tillecki/Miniaturized-PCB-for-MouthIO/Doc/Pictures/Heatplate soldering.jpg

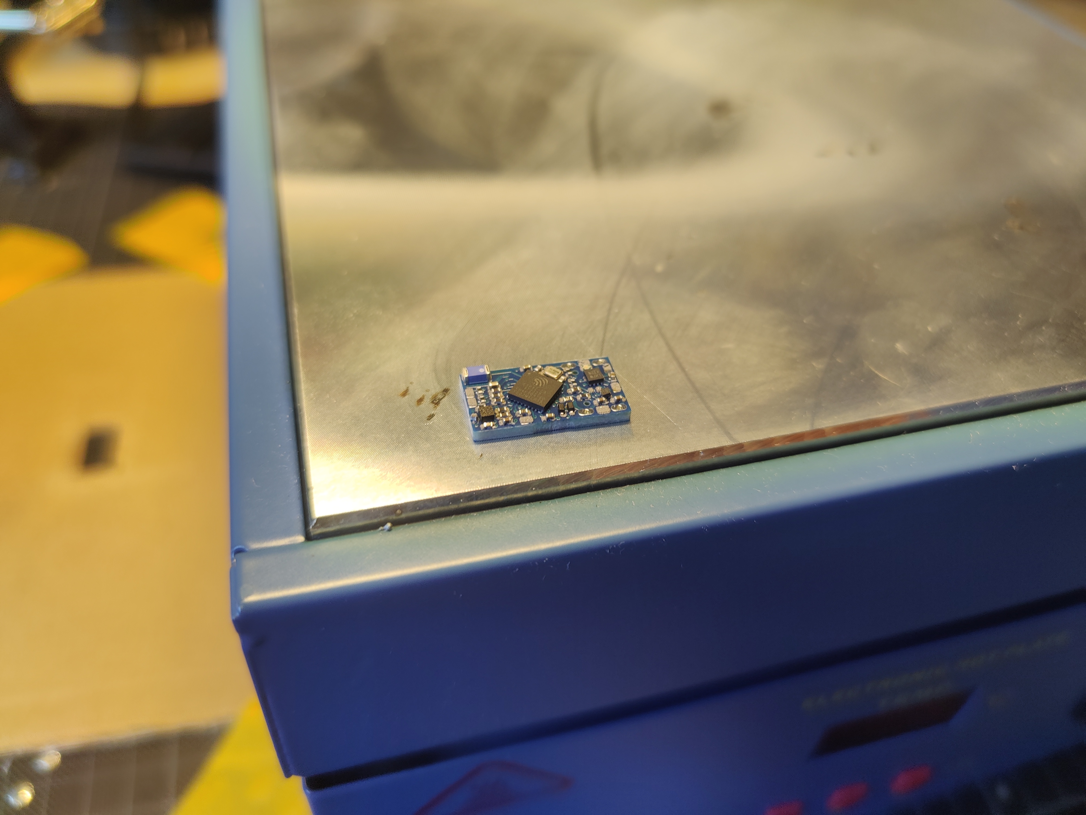
Doc/Pictures/Heatplate soldering.jpg
