tillecki/Miniaturized-PCB-for-MouthIO/Doc/Pictures/CapacitiveTest.png

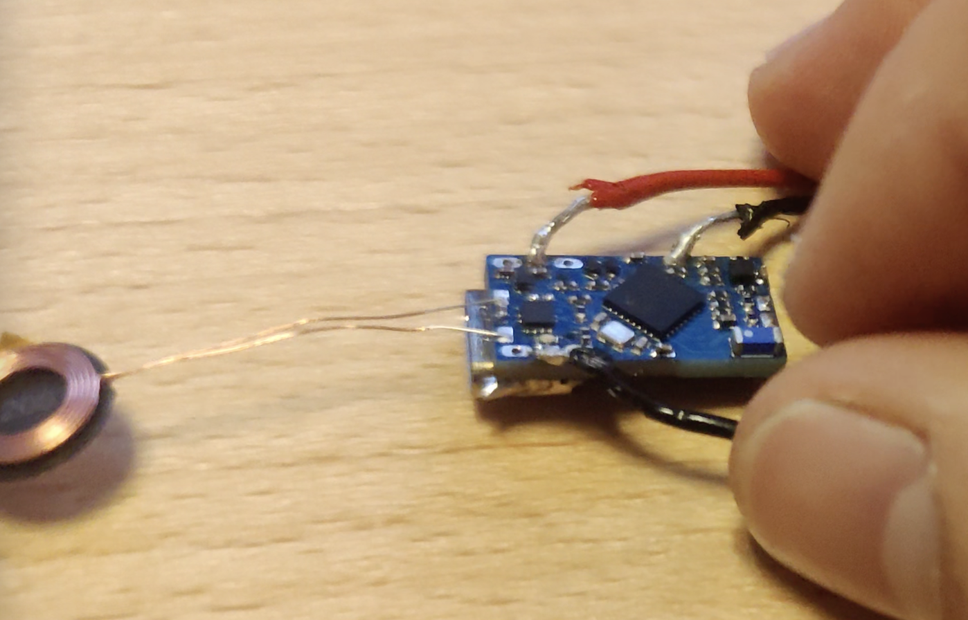
Doc/Pictures/CapacitiveTest.png
