tillecki/Miniaturized-PCB-for-MouthIO/Doc/Pictures/Accelerometertest.png

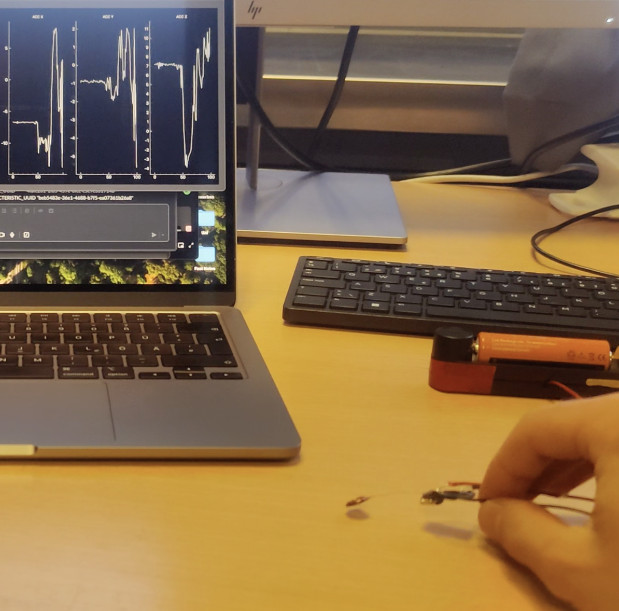
Doc/Pictures/Accelerometertest.png
