tillecki/Miniaturized-PCB-for-MouthIO/Doc/Pictures/Charging on charging station.jpg

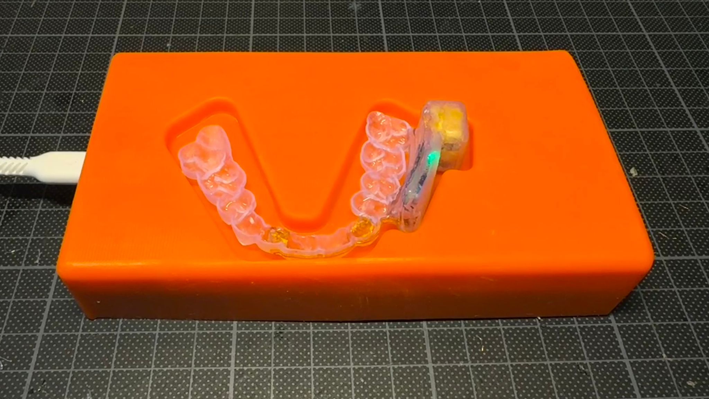
Doc/Pictures/Charging on charging station.jpg
