tillecki/Miniaturized-PCB-for-MouthIO/Doc/Pictures/MouthIO_v3.png

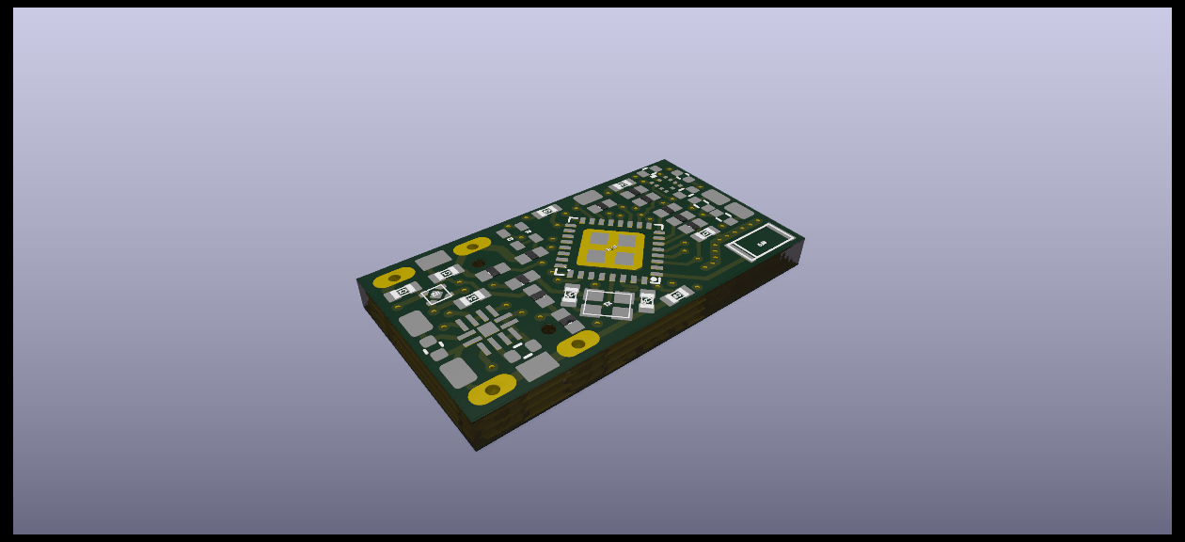
Doc/Pictures/MouthIO_v3.png
