tillecki/Miniaturized-PCB-for-MouthIO/Doc/Pictures/PCB Integrated.jpg

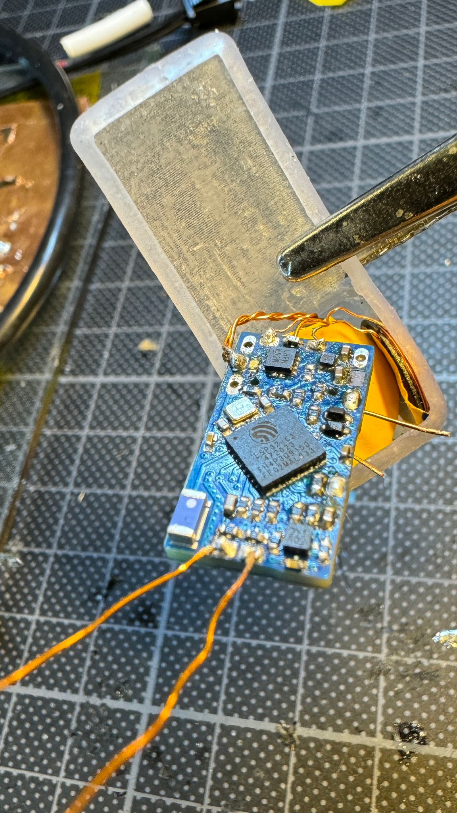
Doc/Pictures/PCB Integrated.jpg
