tillecki/Miniaturized-PCB-for-MouthIO/Doc/Pictures/Program.png

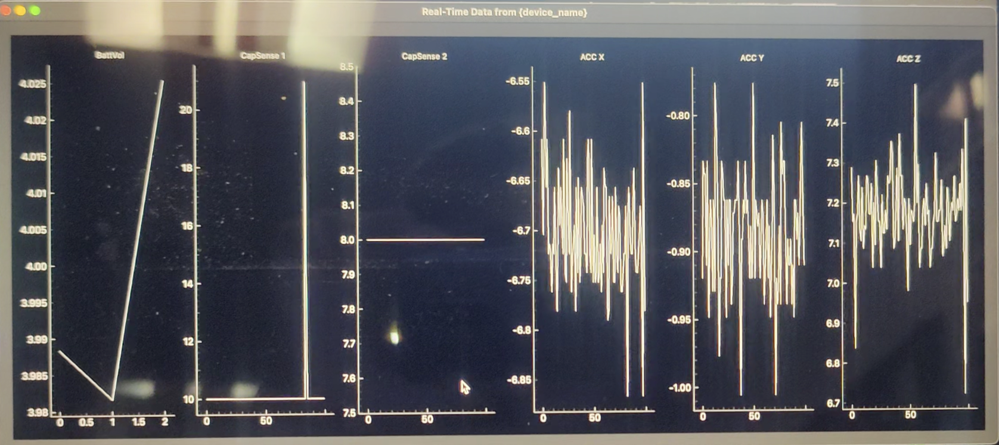
Doc/Pictures/Program.png
