tillecki/Miniaturized-PCB-for-MouthIO/PCB/MouthIO_v3/MouthIO_v3.kicad_pcb

## KiCad design PCB/MouthIO_v3/MouthIO_v3.kicad_pcb (2025-01-16)

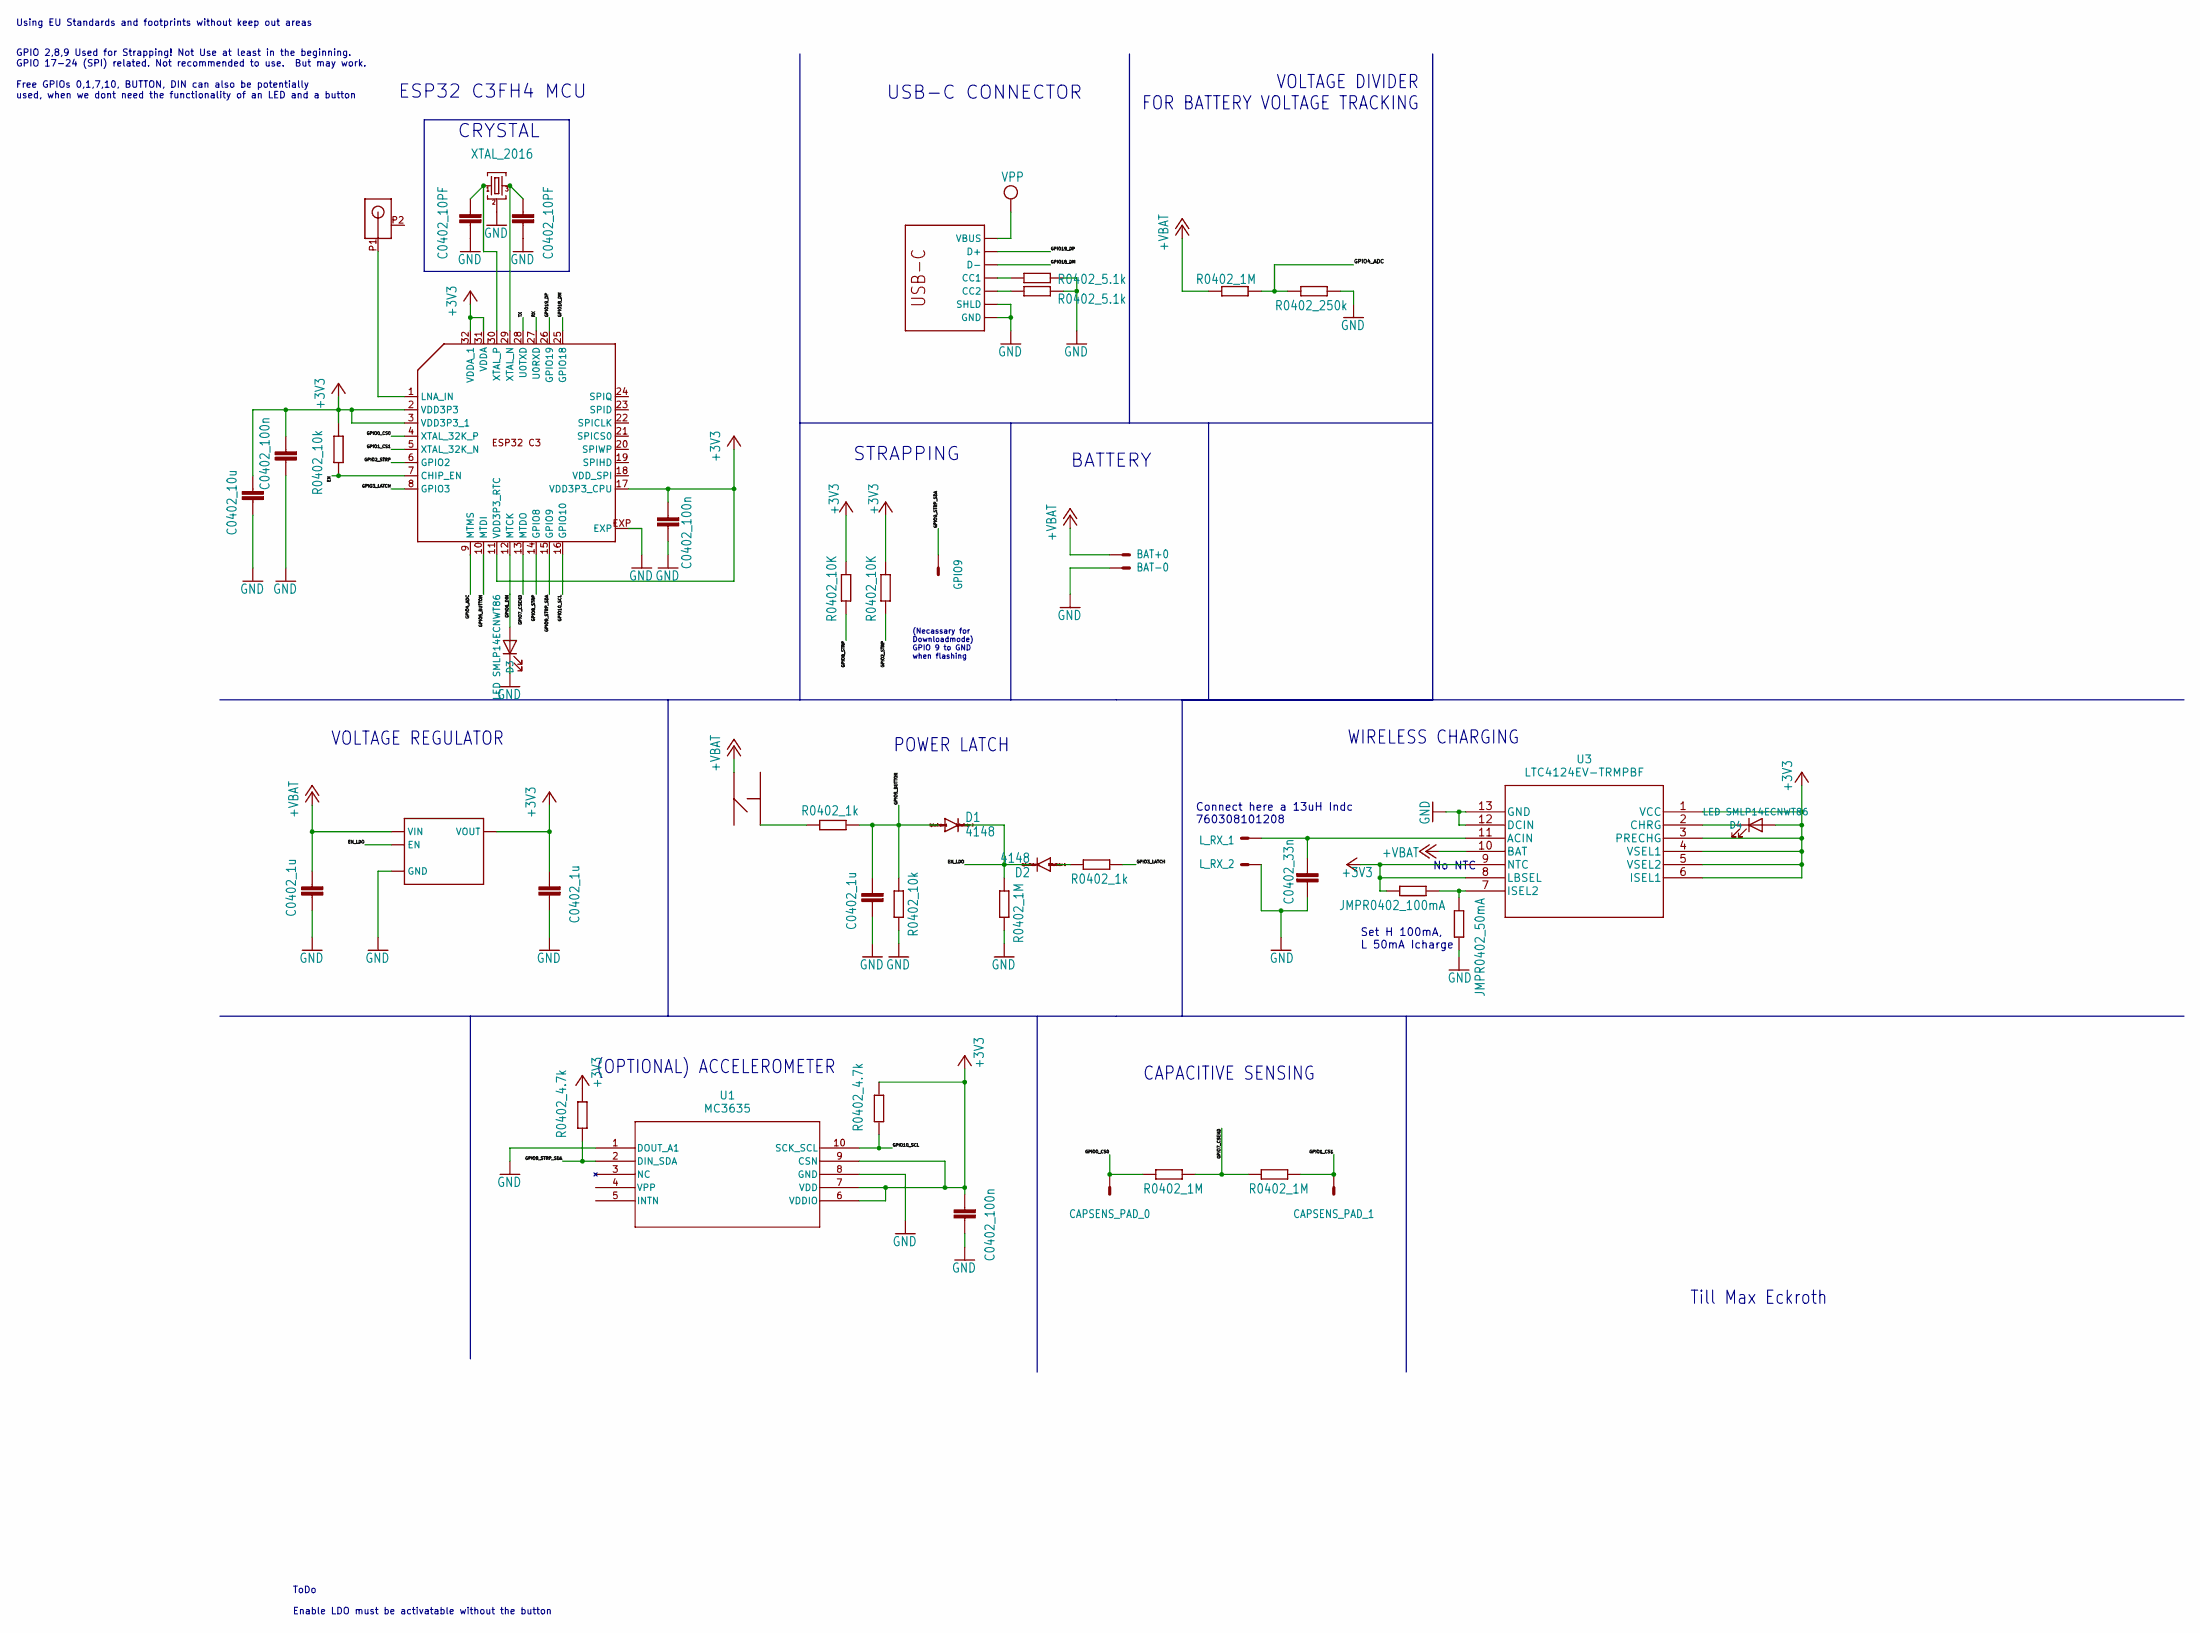
[picture p8: schematic MouthIO_v3.kicad_sch, Mouth]

Parts:
BAT+0: TP/SP-1.5X1.0; Solderpad_1.5_1.0
BAT-0: TP/SP-1.5X1.0; Solderpad_1.5_1.0
C1, C2, C13: C0402_1u; C0402_S
C3: C0402_100n; C_0402_1005Metric
C4: C0402_33n; C_0402_1005Metric
C7: C0402_10u; C0402_S
C8, C9: C0402_100n; C0402_S
C20, C21: C0402_10PF; C0402_S
CAPSENS_PAD_0, CAPSENS_PAD_1: TP/SP-1.5X1.0; Solderpad_1.5_1.0
D1, D2: 4148; SOD523
D3, D4: LED SMLP14ECNWT86; R_0402_1005Metric
ESP1: ESP32_C3_QFN32; QFN32
GPIO9: TP/SP-1.5X1.0; Solderpad_1.5_1.0
L_RX_1, L_RX_2: TP/SP-1.5X1.0; Solderpad_1.5_1.0
R1, R2: R0402_1k; R0402
R3: R0402_1M; R0402
R4, R7: R0402_10k; R0402
R5, R6: R0402_4.7k; R_0402_1005Metric
R8, R9: R0402_1M; R_0402_1005Metric
R10, R11: R0402_10K; R0402
R12, R13: R0402_5.1k; R0402
R15: JMPR0402_100mA; R_0402_1005Metric
R16: JMPR0402_50mA; R_0402_1005Metric
R/1: R0402_1M; R0402
R/2: R0402_250k; R0402
RF0: ANT3216LL00R2400A
U1: MC3635; MC3635_MEM-L
U2: MIC5504; TDFN4
U3: LTC4124EV-TRMPBF
U$1: BUTTON_ST-1187-3
USB-C0: USB_C_C393939; USBC_C393939
X1: XTAL_2016; XTYL_2016

Connections:
+3V3: C2.P$2 (2), C3.2, C7.P$2 (2), C8.P$2 (2), C9.P$2 (2), D4.2 (A), ESP1.2 (VDD3P3), ESP1.3 (VDD3P3_1), ESP1.11 (VDD3P3_RTC), ESP1.17 (VDD3P3_CPU), ESP1.31 (VDDA), ESP1.32 (VDDA_1), R5.1, R6.1, R7.1, R10.1, R11.1, R15.2, U1.6 (VDDIO), U1.7 (VDD), U1.9 (CSN), U2.P1 (VOUT), U3.1 (VCC), U3.3 (PRECHG), U3.4 (VSEL1), U3.5 (VSEL2), U3.6 (ISEL1), U3.8 (LBSEL), U3.9 (NTC)
+VBAT: BAT+0.1 (S), C1.P$2 (2), R/1.1, U2.P4 (VIN), U3.10 (BAT), U$1.P2; also elsewhere on the board
/EN: ESP1.7 (CHIP_EN), R7.2
/EN_LDO: D1.C, D2.C, R3.2, U2.P3 (EN)
/GPIO0_CS0: CAPSENS_PAD_0.1 (S), ESP1.4 (XTAL_32K_P), R8.1
/GPIO1_CS1: CAPSENS_PAD_1.1 (S), ESP1.5 (XTAL_32K_N), R9.2
/GPIO2_STRP: ESP1.6 (GPIO2), R11.2
/GPIO3_LATCH: ESP1.8 (GPIO3), R2.2
/GPIO4_ADC: ESP1.9 (MTMS), R/1.2, R/2.1
/GPIO5_BUTTON: C13.P$2 (2), D1.A, ESP1.10 (MTDI), R1.1, R4.2
/GPIO6_DIN: D3.2 (A), ESP1.12 (MTCK)
/GPIO7_CSEND: ESP1.13 (MTDO), R8.2, R9.1
/GPIO8_STRP: ESP1.14 (GPIO8), R10.2
/GPIO9_STRP_SDA: ESP1.15 (GPIO9), GPIO9.1 (S), R5.2, U1.2 (DIN_SDA)
/GPIO10_SCL: ESP1.16 (GPIO10), R6.2, U1.10 (SCK_SCL)
/GPIO18_DM: ESP1.25 (GPIO18), USB-C0.A7 (D-), USB-C0.B7 (D-)
/GPIO19_DP: ESP1.26 (GPIO19), USB-C0.A6 (D+), USB-C0.B6 (D+)
/RX: ESP1.27 (U0RXD)
/TX: ESP1.28 (U0TXD)
GND: BAT-0.1 (S), C1.P$1 (1), C2.P$1 (1), C3.1, C4.1, C7.P$1 (1), C8.P$1 (1), C9.P$1 (1), C13.P$1 (1), C20.P$1 (1), C21.P$1 (1), D3.1 (K), ESP1.EXP, L_RX_2.1 (S), R3.1, R4.1, R12.2, R13.2, R16.2, R/2.2, U1.1 (DOUT_A1), U1.8 (GND), U2.EXP (GND), U2.P2 (GND), U3.12 (DCIN), U3.13 (GND), USB-C0.A1B12 (GND), USB-C0.B1A12 (GND), USB-C0.S1 (SHLD), USB-C0.S2 (SHLD), USB-C0.S3 (SHLD), USB-C0.S4 (SHLD), X1.P2 (G), X1.P4 (G); also elsewhere on the board
unnamed: C20.P$2 (2), ESP1.30 (XTAL_P), X1.P1 (1)
unnamed: C21.P$2 (2), ESP1.29 (XTAL_N), X1.P3 (2)
unnamed: D2.A, R2.1
unnamed: D4.1 (K), U3.2 (CHRG)
unnamed: ESP1.1 (LNA_IN), RF0.P1 (ANT)
unnamed: C4.2, L_RX_1.1 (S), U3.11 (ACIN)
unnamed: R1.2, U$1.P3
unnamed: R15.1, R16.1, U3.7 (ISEL2)
unnamed: R12.1, USB-C0.A5 (CC1)
unnamed: R13.1, USB-C0.B5 (CC2)
VPP: USB-C0.A4B9 (VBUS), USB-C0.B4A9 (VBUS)

Notes on the sheet:
(Necassary for Downloadmode) GPIO 9 to GND when flashing
WIRELESS CHARGING
BATTERY
(OPTIONAL) ACCELEROMETER
CAPACITIVE SENSING
Set H 100mA, L 50mA Icharge
USB-C CONNECTOR
VOLTAGE REGULATOR
No NTC
CRYSTAL
Connect here a 13uH Indc 760308101208
Using EU Standards and footprints without keep out areas
STRAPPING
GPIO 2,8,9 Used for Strapping! Not Use at least in the beginning. GPIO 17-24 (SPI) related. Not recommended to use. But may work. Free GPIOs 0,1,7,10, BUTTON, DIN can also be potentially used, when we dont need the functionality of an LED and a button
ToDo Enable LDO must be activatable without the button
POWER LATCH
VOLTAGE DIVIDER FOR BATTERY VOLTAGE TRACKING
Till Max Eckroth
ESP32 C3FH4 MCU

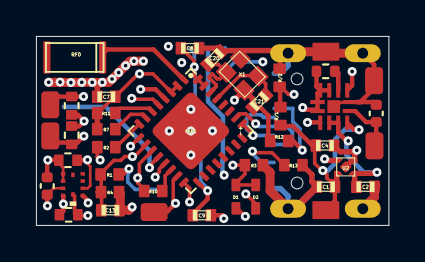
[picture p9: board MouthIO_v3.kicad_pcb from above]

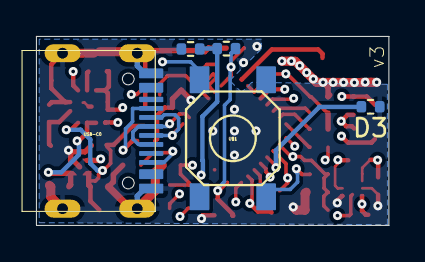
[picture p10: board MouthIO_v3.kicad_pcb from below]

Board: 4 copper layers, 19.6 x 10.5 mm, 47 parts (5 on the bottom side), 29 nets.

Other parts of the board:
C4#2: C-EU-0402-WOKEEPOUT_S; C0402_S

Their connections:
+VBAT: C4#2.P$2 (2); also elsewhere on the board
GND: C4#2.P$1 (1); also elsewhere on the board
